senselabrobo/SenseBeetle-Control-Board-V2.0/hardware/BOM_V2.0_PCB2_2025-03-31.xlsx

No. | Quantity | Comment | Designator | Footprint | Value | Manufacturer Part | Manufacturer | Supplier Part | Supplier
1 | 2 | 20pF | C6,C7 | C0402 | 20pF | 0402CG200J500NT | FH(风华) | C1554 | LCSC
2 | 1 | 470pF | C8 | C0402 | 470pF | GRM1555C1H471JA01D | muRata(村田) | C76971 | LCSC
3 | 1 | 2.2uF | C9 | C0402 | 2.2uF | CL05A225MQ5NSNC | SAMSUNG(三星) | C12530 | LCSC
4 | 1 | 10uF | C10 | C0402 | 10uF | CL05A106MQ5NUNC | SAMSUNG(三星) | C15525 | LCSC
5 | 2 | 10nF | C13,C31 | C0603 | 10nF | 0603B103K500NT | FH(风华) | C57112 | LCSC
6 | 2 | 22uF | C14,C32 | C1206 | 22uF | CL31A226KAHNNNE | SAMSUNG(三星) | C12891 | LCSC
7 | 1 | 100nF | C18 | C0402 | 100nF | CC0402KRX7R7BB104 | YAGEO(国巨) | C60474 | LCSC
8 | 8 | 100nF | C23,C24,C25,C26,C41,C42,C43,C44 | C0402 | 100nF | CL05B104KB54PNC | SAMSUNG(三星) | C307331 | LCSC
9 | 1 | 10uF | C30 | C0603 | 10uF | CL10A106KP8NNNC | SAMSUNG(三星) | C19702 | LCSC
10 | 2 | 10uF | C39,C40 | C0805 | 10uF | GRM21BR61H106KE43L | muRata(村田) | C440198 | LCSC
11 | 5 | GH125-S02DCA-00 | CAN1,CAN2,CAN3,CAN4,CAN5 | CONN-SMD_2P-P1.25_JUSHUO_GH125-S02DCA-00 |  | GH125-S02DCA-00 | JS(钜硕电子) | C2886765 | LCSC
12 | 4 | 测试点 | CMPI,DAC1,TP3,TP5 | 单面测试点
13 | 1 | XT30PW-M | CN1 | CONN-TH_XT30PW-M |  | XT30PW-M | AMASS(艾迈斯) | C431092 | LCSC
14 | 6 | XT30UPB-F30.G.Y | CN2,CN3,CN4,CN5,CN6,CN7 | CONN-TH_XT30UPB-F |  | XT30UPB-F30.G.Y | AMASS(艾迈斯) | C108769 | LCSC
15 | 3 | BAV99 | D1,D3,D9 | SOT-23-3_L2.9-W1.3-P1.90-LS2.4-BR |  | BAV99 | JSMSEMI(杰盛微) | C916421 | LCSC
16 | 3 | B340A | D4,D6,D8 | SMA_L4.3-W2.6-LS5.0-RD |  | B340A | FUXINSEMI(富芯森美) | C3018525 | LCSC
17 | 1 | USBLC6-2P6 | D7 | SOT-666-6_L1.6-W1.2-P0.50-LS1.6-BL |  | USBLC6-2P6 | TECH PUBLIC(台舟) | C2827693 | LCSC
18 | 2 | 22uH | L1,L2 | IND-SMD_L7.1-W6.6 | 22uH | YSPI0630A-220M | YJYCOIN(益嘉源) | C497873 | LCSC
19 | 1 | XL-1615RGBC-RF | LED1 | LED-ARRAY-SMD_4P-L1.6-W1.5-BR_XL-1615RGBC-RF |  | XL-1615RGBC-RF | XINGLIGHT(成兴光) | C965840 | LCSC
20 | 3 | NCD0603B1 | LED2,LED3,LED4 | LED0603-RD |  | NCD0603B1 | 国星光电 | C84266 | LCSC
21 | 1 | AON7544 | Q1 | DFN-8_L3.3-W3.3-P0.65-BL-2 |  | AON7544 | AOS | C315567 | LCSC
22 | 1 | AON7409 | Q2 | DFN-8_L3.0-W3.0-P0.65-BL |  | AON7409 | AOS | C189753 | LCSC
23 | 1 | PMBT3904 | Q4 | SOT-23-3_L2.9-W1.3-P1.90-LS2.4-BR |  | PMBT3904 | PAKER(派克微) | C5278868 | LCSC
24 | 4 | 5.1kΩ | R1,R2,R13,R15 | R0402 | 5.1kΩ | 0402WGF5101TCE | UNI-ROYAL(厚声) | C25905 | LCSC
25 | 2 | 10Ω | R3,R33 | R0402 | 10Ω | 0402WGF100JTCE | UNI-ROYAL(厚声) | C25077 | LCSC
26 | 1 | 3.24kΩ | R5 | R0603 | 3.24kΩ | 0603WAF3241T5E | UNI-ROYAL(厚声) | C22994 | LCSC
27 | 10 | 10kΩ | R6,R7,R14,R68,R69,R70,R71,R80,R81,R83 | R0402 | 10kΩ | 0402WGF1002TCE | UNI-ROYAL(厚声) | C25744 | LCSC
28 | 2 | 196kΩ | R20,R21 | R0603 | 196kΩ | FRC0603F1963TS | FOJAN(富捷) | C2974032 | LCSC
29 | 1 | 100kΩ | R32 | R0603 | 100kΩ | 0603WAF1003T5E | UNI-ROYAL(厚声) | C25803 | LCSC
30 | 1 | 1.4kΩ | R36 | R0603 | 1.4kΩ | 0603WAF1401T5E | UNI-ROYAL(厚声) | C25957 | LCSC
31 | 1 | 86.6kΩ | R37 | R0603 | 86.6kΩ | 0603WAF8662T5E | UNI-ROYAL(厚声) | C23121 | LCSC
32 | 1 | 3.3kΩ | R40 | R0603 | 3.3kΩ | 0603WAF3301T5E | UNI-ROYAL(厚声) | C22978 | LCSC
33 | 2 | 5mΩ | R41,R42 | RES-SMD_L6.4-W3.2-1 | 5mΩ | HoJLR2512-3W-5mR-1% | Milliohm(毫欧) | C2903482 | LCSC
34 | 1 | 10Ω | R52 | R0603 | 10Ω | 0603WAF100JT5E | UNI-ROYAL(厚声) | C22859 | LCSC
35 | 2 | 40.2kΩ | R63,R64 | R0603 | 40.2kΩ | 0603WAF4022T5E | UNI-ROYAL(厚声) | C12447 | LCSC
36 | 1 | 82kΩ | R72 | R0603 | 82kΩ | 0603WAF8202T5E | UNI-ROYAL(厚声) | C23254 | LCSC
37 | 5 | 1kΩ | R74,R75,R84,R85,R86 | R0402 | 1kΩ | 0402WGF1001TCE | UNI-ROYAL(厚声) | C11702 | LCSC
38 | 3 | 1kΩ | R77,R78,R79 | R0603 | 1kΩ | 0603WAF1001T5E | UNI-ROYAL(厚声) | C21190 | LCSC
39 | 1 | 120Ω | R87 | R0603 | 120Ω | 0603WAF1200T5E | UNI-ROYAL(厚声) | C22787 | LCSC
40 | 1 | TS-1089S-02526 | SW1 | SW-SMD_4P-L4.2-W3.3-P2.15-LS5.1 |  | TS-1089S-02526 | XUNPU(讯普) | C455282 | LCSC
41 | 1 | STM32F072CBT6 | U5 | LQFP-48_L7.0-W7.0-P0.50-LS9.0-BL |  | STM32F072CBT6 | ST(意法半导体) | C81720 | LCSC
42 | 1 | MIC5219-3.3YM5-TR | U6 | SOT-23-5_L3.0-W1.7-P0.95-LS2.8-TL |  | MIC5219-3.3YM5-TR | MICROCHIP(美国微芯) | C29613 | LCSC
43 | 1 | XL1050 | U7 | SOIC-8_L4.9-W3.9-P1.27-LS6.0-BL |  | XL1050 | XINLUDA(信路达) | C609746 | LCSC
44 | 2 | TPS5430DDA | U11,U18 | ESOP-8_L4.9-W3.9-P1.27-LS6.0-BL-EP-2 |  | TPS5430DDA | TI(德州仪器) | C502477 | LCSC
45 | 1 | WAFER-GH1.25-5PWB | U12 | CONN-SMD_5P-P1.25_XUNPU_WAFER-GH1.25-5PWB |  | WAFER-GH1.25-5PWB | XUNPU(讯普) | C3029380 | LCSC
46 | 1 | LM358DR | U19 | SOIC-8_L5.0-W4.0-P1.27-LS6.0-BL |  | LM358DR | TI(德州仪器) | C5423 | LCSC
47 | 2 | GH125-S04DCA-00 | UART1,UART2 | CONN-SMD_4P-P1.27_GH125-S04DCA-00 |  | GH125-S04DCA-00 | JS(钜硕电子) | C2886767 | LCSC
48 | 1 | TYPE-C 16P QTWT | USB1 | USB-TYPE-C-SMD_TYPE-C-16P-QTWT |  | TYPE-C 16P QTWT | SHOU HAN(首韩) | C5187472 | LCSC
49 | 1 | 8MHz | X1 | CRYSTAL-SMD_4P-L3.2-W2.5-BL | 8MHz | X32258MSB4SI | YXC(扬兴晶振) | C2682774 | LCSC
