senselabrobo/SenseBeetle-Control-Board-V2.0/hardware/SCH_Schematic_2025-03-31.pdf

V1.0：

V2.0：

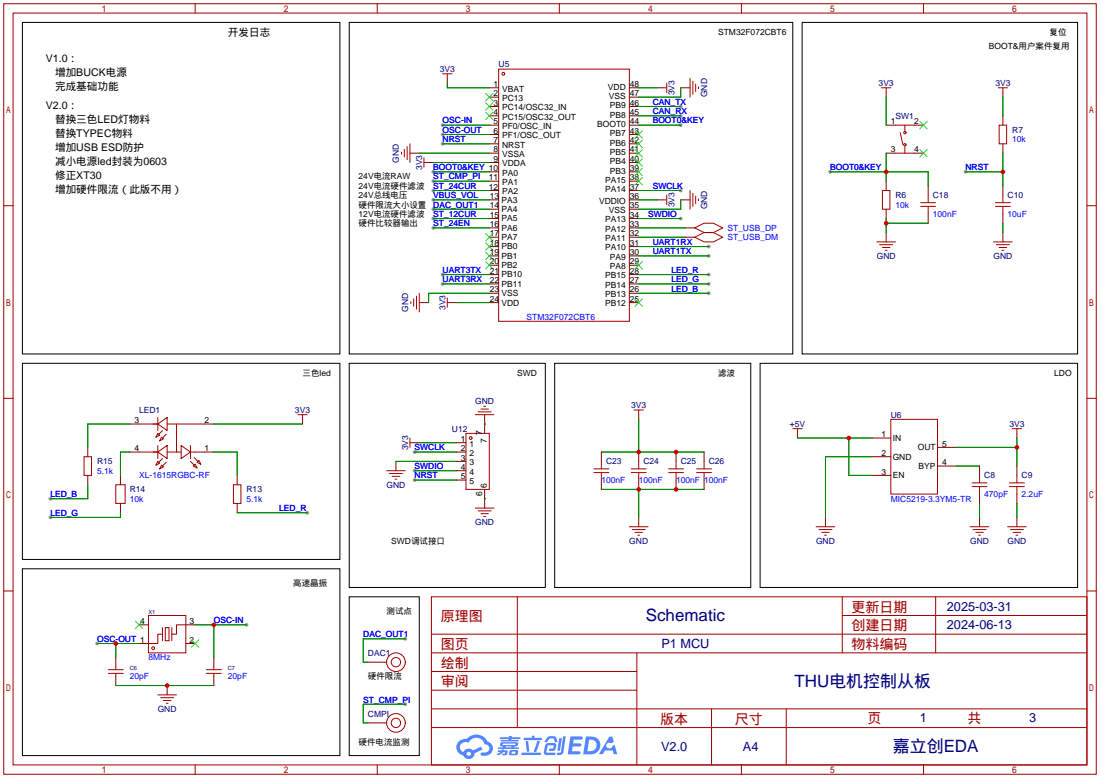
[picture p3: page 1]

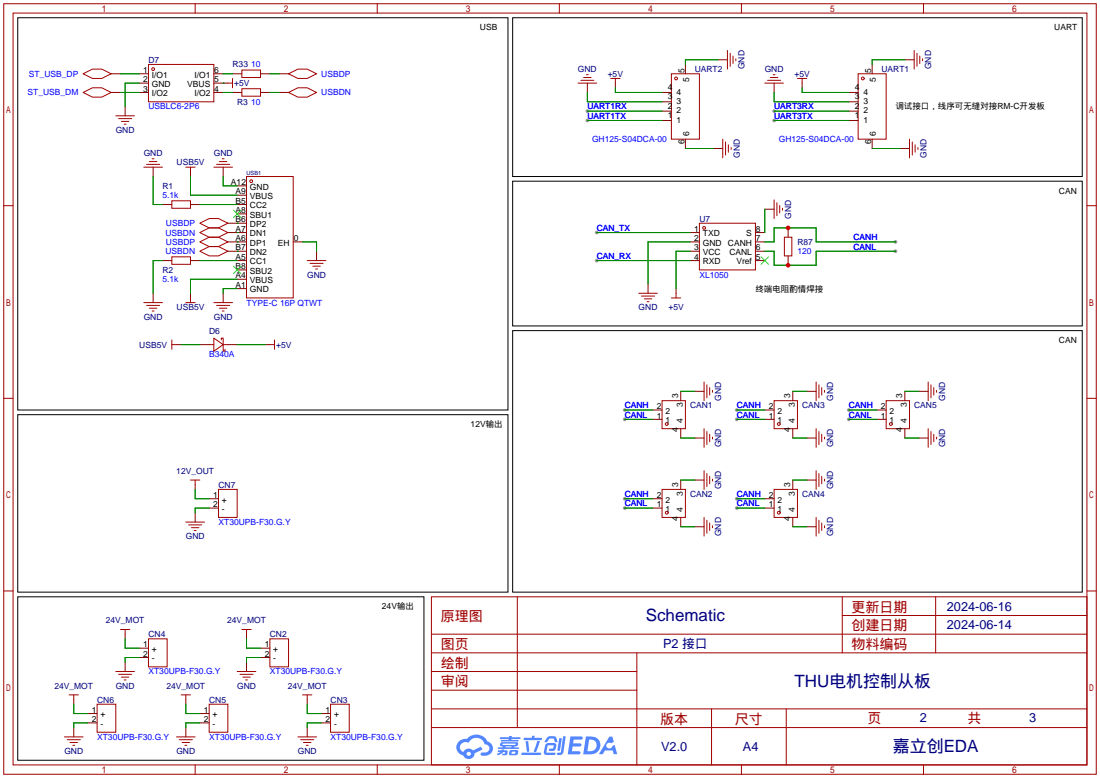
[picture p4: page 2]

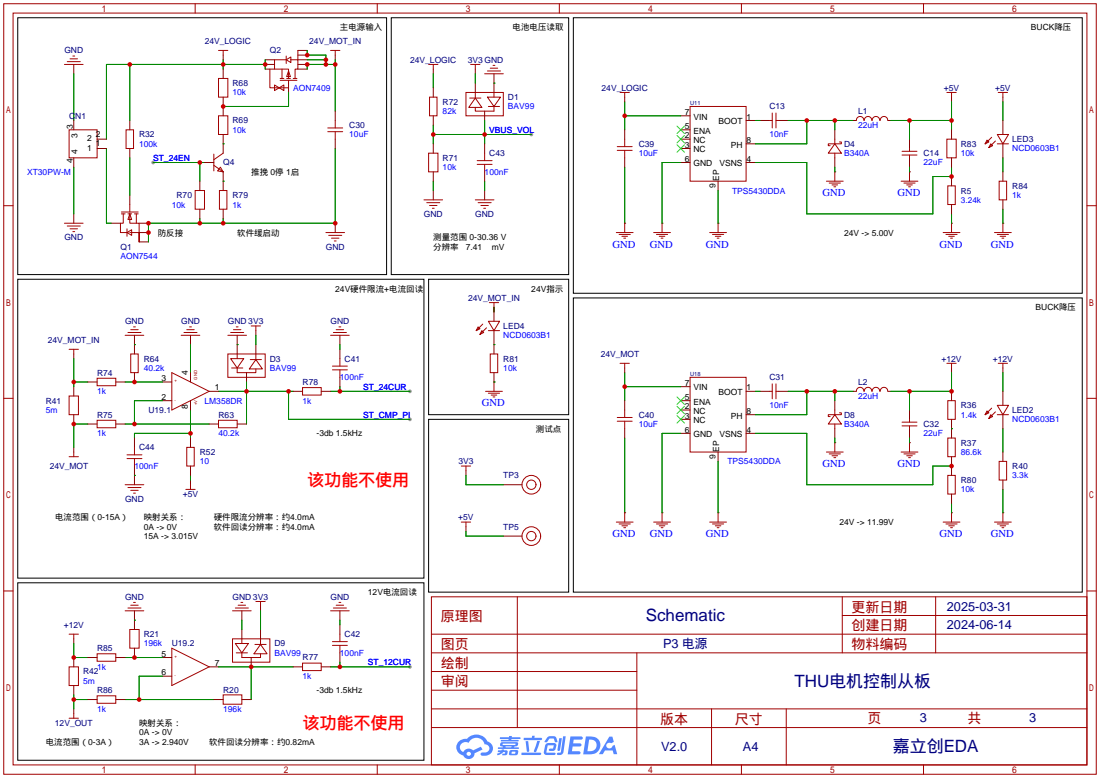
[picture p5: page 3]
