senselabrobo/SenseBeetle-Control-Board-V2.0/software/Control BoardV1.1/Core/Inc/main.h

#define KEY_Pin GPIO_PIN_0
#define KEY_GPIO_Port GPIOA
#define LED_B_Pin GPIO_PIN_13
#define LED_B_GPIO_Port GPIOB
#define LED_G_Pin GPIO_PIN_14
#define LED_G_GPIO_Port GPIOB
#define LED_R_Pin GPIO_PIN_15
#define LED_R_GPIO_Port GPIOB
