senselabrobo/SenseBeetle-Control-Board-V2.0/software/Control BoardV1.1/APP/MotorTask.h

#ifndef __MOTOR_TASK_H
#define __MOTOR_TASK_H

#include "main.h"

void MotorTask_Handle(void const * argument);

void MotorTask_SetMotorPidSpd(uint8_t id, int16_t spd);			//(API)设置电机速度id0-3，spd -5000-5000
void MotorTask_MotorPowerOffAll(void);											//(API)所有电机立即断电


#endif	//__MOTOR_TASK_H
